woczach/wodox/outputs/outlines/stl/wodox_bottom_left.stl

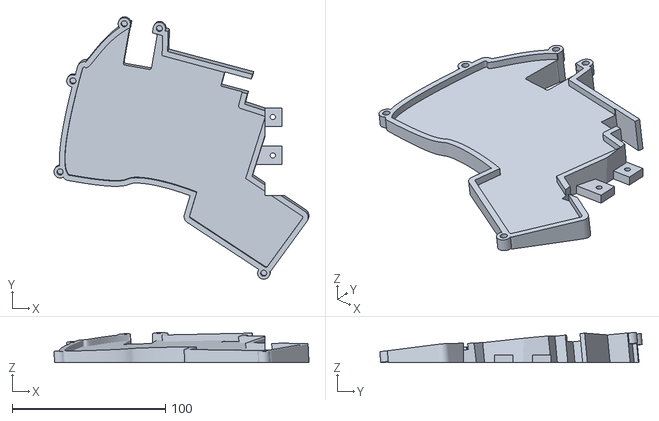
[picture p1: CAD file, 2026-10-24]
outputs/outlines/stl/wodox_bottom_left.stl
166.3 x 171.2 x 19.6
