woczach/wodox/outputs/outlines/wodox_board.stl

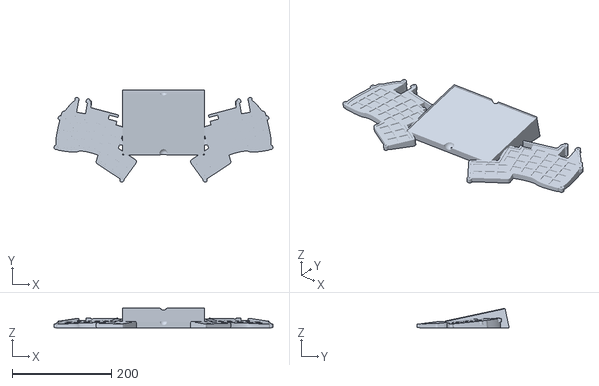
[picture p2: CAD file, 2026-10-24]
outputs/outlines/wodox_board.stl
441.4 x 186.3 x 39.3
