woczach/wodox/outputs/outlines/stl/wodox_top_right.stl

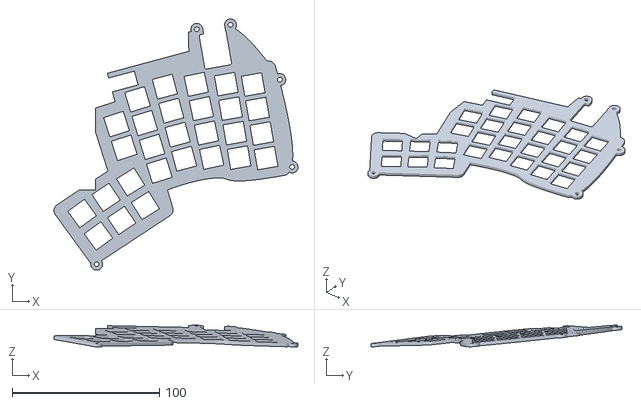
[picture p3: CAD file, 2026-10-24]
outputs/outlines/stl/wodox_top_right.stl
165.9 x 170.8 x 14.9
