woczach/wodox/outputs/outlines/wodox_board_edgetcuts_raw.dxf

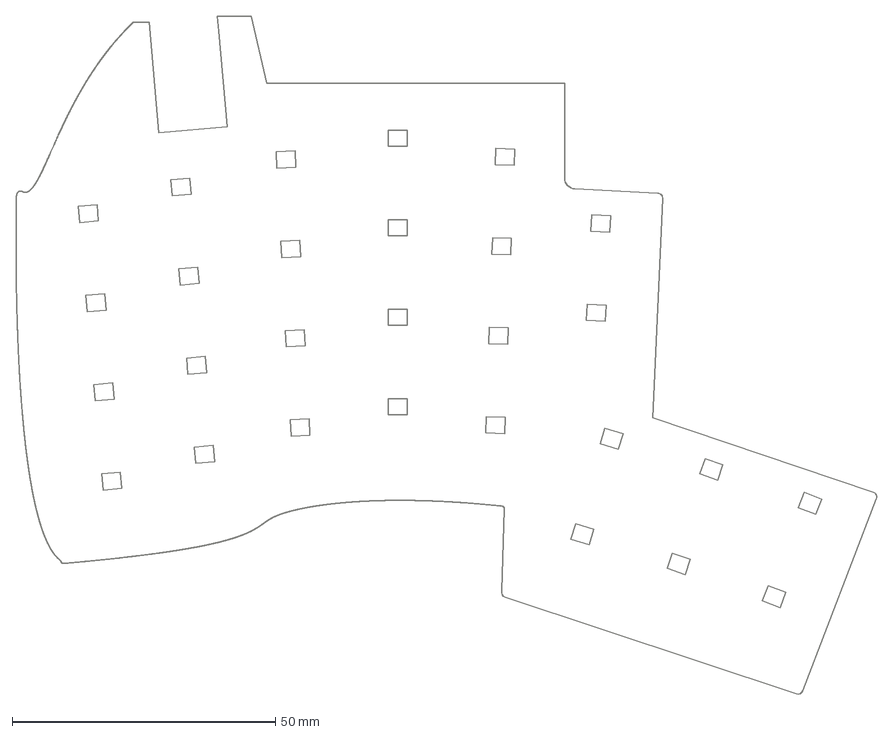
[picture p4: CAD file, 2026-10-01]
outputs/outlines/wodox_board_edgetcuts_raw.dxf
163.6 x 128.9 mm
