woczach/wodox/outputs/outlines/raw.dxf

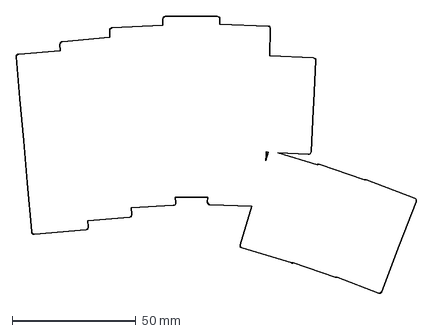
[picture p5: CAD file, 2026-09-26]
outputs/outlines/raw.dxf
161.9 x 112.0 mm
