woczach/wodox/outputs/outlines/board.dxf

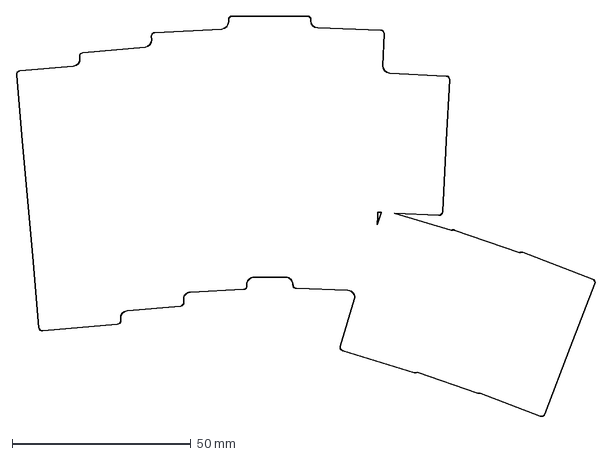
[picture p6: CAD file, 2026-09-26]
outputs/outlines/board.dxf
161.9 x 112.0 mm
