woczach/wodox/outputs/outlines/wodox_board.scad

// Wodox keyboard PCB outline - auto-generated from main_pcb.kicad_pcb (Edge.Cuts)
// Units: millimetres. Origin = board lower-left corner. Board: 163.551 x 128.759 mm.
// Use the embedded polygon below, or uncomment the DXF imports at the bottom.

BOARD_THICKNESS = 2.2;      // solid height (mm) - needs to exceed LIP_Z1
WANT_CUTOUTS    = true;     // 28 stepped Choc v1 switch cutouts
// Choc v1 stepped cutout profile (all squares, centred on each switch):
CHOC_OUTER      = 14.7;     // size below and above the lip
CHOC_LIP        = 14.0;     // retention lip size
LIP_Z0          = 0.95;      // lip bottom height
LIP_Z1          = 2.05;      // lip top height
$fn = 48;

// RP2040-Matrix module placement (from KiCad footprint Cmts.User layer)
RP2040_POS = [32.898, 116.202];     // module centre, SCAD coords
RP2040_ROT = 5;                     // KiCad footprint rotation (deg)

// PJ320E 3.5mm audio jack placement (from KiCad footprint F.SilkS layer)
PJ320E_POS = [91.95, 114.3325];     // jack footprint centre, SCAD coords
PJ320E_ROT = -90;                   // KiCad footprint rotation (deg)

// Jack plug clearance: 1 cm opening, and 1 cm past the PCB edge at the jack.
JACK_PLUG_D   = 10;                 // clearance across the plug (mm)
JACK_EXT      = 10;                 // clearance beyond the PCB edge (mm)
JACK_PCB_EDGE = 104.2393;           // x of the board edge next to the jack
JACK_INNER_Y  = 2.1;                // jack body inner face (local y)
JACK_OUTER_Y  = PJ320E_POS[0] - (JACK_PCB_EDGE + JACK_EXT);

// Split: the second half is a mirror of the first, placed to the right
GAP        = 0;                    // single layout gap, all elements (0 = touching)
HALF_ROT   = -15;                   // rotate each half inward (deg)
HALF_TILT  = 6;                     // tilt each half about the two bottom screws (deg)

// Bottom plate: same outline as the board, solid (no switch cutouts)
PLATE_THICKNESS = 3;                // plate thickness (mm)

// Touchpad base (from ~/git/other/tuchpad base.scad)
// The source is Y-up: the flat touchpad face points towards +Y, the slanted
// underside towards -Y and the thick/high edge towards +X. The slanted
// underside is the bottom, so it is levelled onto the print bed below; the
// flat face then becomes the inclined touchpad surface.
TOUCHPAD      = true;               // place the touchpad base between the halves
TP_LONG       = 123.3;              // inner/touchpad depth (outer = +2*TP_WALL)
TP_LONG2      = 163;                // inner/touchpad width (outer = +2*TP_WALL)
TP_WALL       = 1.5;                // material thickness
TP_H1         = 1.5;                // flat-face edge offset
TP_H2         = 2.5;                // edge step height
TP_HW1        = 13.2;               // low end thickness
TP_HW2        = 40.2;               // high end thickness
TP_HW3        = 13;                 // side/end thickness
TP_TALL_WALL  = "back";             // thick edge: "back" (+Y) or "front" (-Y)

TP_OUTER_W    = TP_LONG2 + 2*TP_WALL;  // 166.0 - width across the split
TP_OUTER_D    = TP_LONG  + 2*TP_WALL;  // 126.3 - depth front-to-back
TP_LEVEL      = atan2(TP_HW2 - TP_HW1, TP_OUTER_D);  // underside slope (deg)

// Clearance between the real PCB and the printed parts (per side, mm)
PCB_CLEARANCE   = 0.2;

// Outline (wall) around each plate
OUTLINE         = 3.5;                // outline width, outward (mm)
TOP_OUTLINE_H   = BOARD_THICKNESS;  // top plate outline height (mm) = 3
BOT_OUTLINE_H   = 7;                // bottom plate outline height (mm)

// Screw joints: M3 heat-set inserts in the bottom outline, M3 clearance in top
M3_INSERT_D     = 4.0;              // insert hole diameter (mm)
M3_INSERT_H     = 5.1;              // insert hole depth (mm)
M3_CLEAR_D      = 3.4;              // M3 screw clearance hole diameter (mm)
SCREW_BOSS_WALL = 2;                // wall around each screw / barrel (mm)
// Screw centres, on the ring mid-line (SCAD coords). One half; mirrored with it.
// Offsets set so each screw's barrel (OD M3_INSERT_D+2*SCREW_BOSS_WALL) has
// its inner edge on the board outline -> not inside the plates.
// The two bottom screws define the single tilt axis (see half_transform).
SCREW_BOTTOM_LEFT  = [  3.11,  25.22];
SCREW_BOTTOM_RIGHT = [148.48,  -4.20];
screws = [
  [ 41.50, 132.96],   // top
 // [167.75,  37.31],   // right / thumb
  SCREW_BOTTOM_RIGHT,  // bottom-right
  //[ 88.33,  31.04],   // bottom-middle
  SCREW_BOTTOM_LEFT,   // bottom-left
  //[120.26,  99.44],   // upper-right corner
  [ -4.20,  85.00],   // left-upper
  [ 18.61, 129.90],   // top-left
];

// Extra clearance around the component cutouts so the modules drop in cleanly.
COMPONENT_CLEARANCE = 0.3;          // per side (mm)

// The RP2040 USB exit must be fully open between the two top screws. Widen the
// USB cutout to the clear gap between their boss circles so no board is left
// between the screws (the bosses themselves stay intact).
USB_BOSS_R  = M3_INSERT_D/2 + SCREW_BOSS_WALL;
function _usb_local_x(p) =
    (p[0]-RP2040_POS[0])*cos(RP2040_ROT) + (p[1]-RP2040_POS[1])*sin(RP2040_ROT);
USB_GAP_MIN = _usb_local_x(screws[len(screws)-1]) + USB_BOSS_R;  // top-left screw
USB_GAP_MAX = _usb_local_x(screws[0]) - USB_BOSS_R;              // top screw
USB_GAP_W   = USB_GAP_MAX - USB_GAP_MIN;
USB_GAP_CX  = (USB_GAP_MIN + USB_GAP_MAX)/2;

outer = [[122.8791,94.0923],[122.8803,94.1250],[122.8804,94.1577],[122.8794,94.1904],[122.8774,94.2231],[122.8743,94.2557],[122.8701,94.2881],[122.8649,94.3204],[122.8586,94.3526],[122.8513,94.3844],[122.8429,94.4161],[122.8335,94.4474],[122.8231,94.4784],[122.8117,94.5091],[122.7993,94.5394],[122.7859,94.5692],[122.7715,94.5986],[122.7562,94.6275],[122.7399,94.6559],[122.7227,94.6838],[122.7046,94.7111],[122.6856,94.7377],[122.6658,94.7637],[122.6451,94.7891],[122.6236,94.8138],[122.6013,94.8377],[122.5783,94.8610],[122.5545,94.8834],[122.5299,94.9051],[122.5047,94.9259],[122.4788,94.9459],[122.4523,94.9651],[122.4251,94.9833],[122.3974,95.0007],[122.3691,95.0171],[122.3403,95.0327],[122.3110,95.0472],[122.2812,95.0608],[122.2510,95.0735],[122.2204,95.0851],[122.1895,95.0957],[122.1582,95.1053],[122.1266,95.1139],[122.0948,95.1214],[122.0627,95.1279],[122.0304,95.1333],[121.9980,95.1377],[121.9654,95.1410],[121.9328,95.1433],[106.1334,95.9713],[106.0688,95.9757],[106.0044,95.9822],[105.9403,95.9908],[105.8765,96.0015],[105.8130,96.0142],[105.7500,96.0290],[105.6875,96.0458],[105.6256,96.0646],[105.5643,96.0855],[105.5037,96.1082],[105.4439,96.1330],[105.3849,96.1596],[105.3269,96.1882],[105.2697,96.2186],[105.2136,96.2508],[105.1586,96.2849],[105.1047,96.3207],[105.0520,96.3582],[105.0005,96.3975],[104.9503,96.4383],[104.9014,96.4808],[104.8540,96.5248],[104.8080,96.5704],[104.7635,96.6174],[104.7206,96.6658],[104.6792,96.7156],[104.6395,96.7667],[104.6015,96.8190],[104.5651,96.8726],[104.5305,96.9273],[104.4977,96.9831],[104.4668,97.0399],[104.4376,97.0977],[104.4104,97.1564],[104.3851,97.2160],[104.3617,97.2763],[104.3403,97.3374],[104.3209,97.3991],[104.3034,97.4614],[104.2880,97.5243],[104.2747,97.5876],[104.2634,97.6514],[104.2542,97.7154],[104.2470,97.7797],[104.2419,97.8443],[104.2390,97.9089],[104.2381,97.9736],[104.2393,98.0383],[104.2393,116.0264],[47.6811,116.0264],[44.6811,128.7592],[38.2774,128.7592],[38.5301,125.8702],[40.1164,107.7395],[27.1658,106.6065],[25.3268,127.6262],[22.2811,127.6262],[21.3781,126.7369],[20.5062,125.8325],[19.6645,124.9147],[18.8523,123.9849],[18.0690,123.0449],[17.3137,122.0962],[16.5857,121.1404],[15.8843,120.1791],[15.2088,119.2138],[14.5583,118.2463],[13.9321,117.2781],[13.3295,116.3107],[12.7498,115.3458],[12.1922,114.3850],[11.6560,113.4298],[11.1404,112.4819],[10.6446,111.5429],[10.1680,110.6143],[9.7098,109.6977],[9.2692,108.7948],[8.8456,107.9071],[8.4381,107.0363],[8.0460,106.1838],[7.6686,105.3514],[7.3051,104.5406],[6.9548,103.7530],[6.6170,102.9902],[6.2909,102.2539],[5.9757,101.5455],[5.6707,100.8667],[5.3753,100.2190],[5.0885,99.6042],[4.8097,99.0237],[4.5382,98.4793],[4.2732,97.9723],[4.0139,97.5046],[3.7597,97.0776],[3.5097,96.6929],[3.2632,96.3522],[3.0195,96.0570],[2.7779,95.8090],[2.5375,95.6096],[2.2978,95.4607],[2.0578,95.3636],[1.8169,95.3200],[1.5743,95.3316],[1.3293,95.3999],[1.0811,95.5264],[1.0439,95.5378],[1.0072,95.5468],[0.9710,95.5537],[0.9354,95.5583],[0.9003,95.5609],[0.8659,95.5614],[0.8320,95.5599],[0.7987,95.5565],[0.7660,95.5513],[0.7339,95.5442],[0.7025,95.5354],[0.6717,95.5249],[0.6416,95.5127],[0.6121,95.4990],[0.5833,95.4838],[0.5552,95.4672],[0.5277,95.4491],[0.5010,95.4298],[0.4750,95.4091],[0.4497,95.3873],[0.4252,95.3643],[0.4014,95.3402],[0.3784,95.3150],[0.3561,95.2889],[0.3346,95.2619],[0.3139,95.2341],[0.2940,95.2054],[0.2750,95.1760],[0.2567,95.1460],[0.2393,95.1153],[0.2227,95.0841],[0.2070,95.0524],[0.1922,95.0202],[0.1782,94.9877],[0.1651,94.9548],[0.1530,94.9218],[0.1417,94.8885],[0.1314,94.8550],[0.1220,94.8215],[0.1135,94.7880],[0.1060,94.7545],[0.0995,94.7212],[0.0939,94.6880],[0.0893,94.6550],[0.0857,94.6223],[0.0832,94.5899],[0.0816,94.5579],[0.0811,94.5264],[0.0793,94.4468],[0.0742,94.2120],[0.0667,93.8284],[0.0573,93.3024],[0.0468,92.6402],[0.0360,91.8483],[0.0254,90.9330],[0.0158,89.9006],[0.0079,88.7574],[0.0024,87.5098],[0.0000,86.1641],[0.0014,84.7267],[0.0072,83.2038],[0.0183,81.6019],[0.0353,79.9273],[0.0588,78.1862],[0.0896,76.3851],[0.1284,74.5303],[0.1760,72.6281],[0.2329,70.6849],[0.2998,68.7069],[0.3776,66.7006],[0.4669,64.6722],[0.5683,62.6282],[0.6827,60.5748],[0.8106,58.5184],[0.9528,56.4653],[1.1100,54.4218],[1.2829,52.3944],[1.4722,50.3892],[1.6785,48.4128],[1.9027,46.4713],[2.1453,44.5712],[2.4071,42.7188],[2.6888,40.9204],[2.9911,39.1823],[3.3147,37.5110],[3.6603,35.9127],[4.0285,34.3937],[4.4201,32.9605],[4.8358,31.6193],[5.2763,30.3764],[5.7423,29.2383],[6.2345,28.2113],[6.7535,27.3016],[7.3001,26.5157],[7.8750,25.8599],[8.4789,25.3404],[8.4821,25.3205],[8.4860,25.3006],[8.4905,25.2810],[8.4956,25.2614],[8.5014,25.2421],[8.5079,25.2229],[8.5150,25.2040],[8.5226,25.1853],[8.5310,25.1669],[8.5399,25.1488],[8.5494,25.1310],[8.5595,25.1135],[8.5702,25.0963],[8.5814,25.0796],[8.5932,25.0632],[8.6055,25.0472],[8.6184,25.0316],[8.6318,25.0164],[8.6456,25.0017],[8.6600,24.9875],[8.6748,24.9738],[8.6900,24.9605],[8.7057,24.9478],[8.7218,24.9356],[8.7383,24.9240],[8.7552,24.9128],[8.7724,24.9023],[8.7900,24.8923],[8.8079,24.8830],[8.8261,24.8742],[8.8446,24.8660],[8.8633,24.8585],[8.8823,24.8516],[8.9015,24.8453],[8.9209,24.8397],[8.9404,24.8347],[8.9602,24.8303],[8.9800,24.8266],[9.0000,24.8236],[9.0201,24.8212],[9.0402,24.8195],[9.0604,24.8185],[9.0806,24.8182],[9.1008,24.8185],[9.1209,24.8195],[9.1411,24.8211],[9.1611,24.8235],[9.1811,24.8264],[11.4319,25.0267],[13.5858,25.2274],[15.6452,25.4284],[17.6125,25.6297],[19.4900,25.8313],[21.2801,26.0329],[22.9852,26.2346],[24.6075,26.4362],[26.1495,26.6376],[27.6135,26.8389],[29.0019,27.0399],[30.3170,27.2405],[31.5613,27.4407],[32.7370,27.6403],[33.8465,27.8393],[34.8922,28.0376],[35.8765,28.2351],[36.8016,28.4317],[37.6700,28.6274],[38.4841,28.8221],[39.2461,29.0157],[39.9584,29.2081],[40.6235,29.3992],[41.2436,29.5889],[41.8211,29.7773],[42.3585,29.9641],[42.8579,30.1493],[43.3219,30.3329],[43.7527,30.5147],[44.1528,30.6946],[44.5244,30.8726],[44.8700,31.0487],[45.1919,31.2226],[45.4924,31.3944],[45.7740,31.5639],[46.0389,31.7311],[46.2896,31.8959],[46.5284,32.0582],[46.7576,32.2180],[46.9797,32.3751],[47.1970,32.5294],[47.4118,32.6809],[47.6265,32.8296],[47.8434,32.9752],[48.0650,33.1178],[48.2936,33.2573],[48.5315,33.3935],[48.7811,33.5264],[49.0508,33.6584],[49.3473,33.7916],[49.6706,33.9258],[50.0207,34.0605],[50.3978,34.1955],[50.8016,34.3305],[51.2324,34.4652],[51.6900,34.5991],[52.1744,34.7320],[52.6858,34.8637],[53.2240,34.9936],[53.7891,35.1217],[54.3812,35.2474],[55.0001,35.3705],[55.6459,35.4907],[56.3187,35.6077],[57.0184,35.7211],[57.7450,35.8306],[58.4985,35.9359],[59.2790,36.0367],[60.0864,36.1327],[60.9208,36.2234],[61.7822,36.3087],[62.6705,36.3882],[63.5858,36.4615],[64.5280,36.5284],[65.4973,36.5886],[66.4935,36.6416],[67.5168,36.6873],[68.5670,36.7252],[69.6443,36.7550],[70.7486,36.7765],[71.8798,36.7893],[73.0382,36.7931],[74.2235,36.7875],[75.4359,36.7723],[76.6754,36.7472],[77.9419,36.7117],[79.2354,36.6656],[80.5561,36.6086],[81.9038,36.5403],[83.2786,36.4605],[84.6804,36.3687],[86.1094,36.2648],[87.5654,36.1483],[89.0486,36.0190],[90.5589,35.8764],[92.0962,35.7204],[92.1175,35.7231],[92.1388,35.7250],[92.1602,35.7261],[92.1816,35.7264],[92.2030,35.7260],[92.2244,35.7249],[92.2457,35.7230],[92.2669,35.7203],[92.2881,35.7168],[92.3091,35.7126],[92.3299,35.7077],[92.3505,35.7020],[92.3710,35.6956],[92.3911,35.6885],[92.4111,35.6806],[92.4307,35.6721],[92.4500,35.6628],[92.4689,35.6529],[92.4875,35.6423],[92.5058,35.6310],[92.5235,35.6191],[92.5409,35.6066],[92.5578,35.5935],[92.5742,35.5797],[92.5901,35.5654],[92.6055,35.5505],[92.6204,35.5351],[92.6347,35.5192],[92.6484,35.5028],[92.6615,35.4858],[92.6741,35.4685],[92.6859,35.4507],[92.6972,35.4325],[92.7078,35.4139],[92.7177,35.3949],[92.7269,35.3756],[92.7355,35.3559],[92.7433,35.3360],[92.7504,35.3158],[92.7568,35.2954],[92.7625,35.2747],[92.7674,35.2539],[92.7716,35.2329],[92.7750,35.2118],[92.7777,35.1905],[92.7796,35.1692],[92.7807,35.1478],[92.7811,35.1264],[92.2996,19.6387],[92.2905,19.6073],[92.2825,19.5755],[92.2755,19.5436],[92.2696,19.5114],[92.2647,19.4790],[92.2609,19.4465],[92.2582,19.4139],[92.2565,19.3812],[92.2559,19.3485],[92.2564,19.3158],[92.2579,19.2831],[92.2605,19.2505],[92.2642,19.2180],[92.2689,19.1856],[92.2747,19.1534],[92.2815,19.1214],[92.2894,19.0896],[92.2983,19.0582],[92.3083,19.0270],[92.3192,18.9961],[92.3312,18.9657],[92.3441,18.9356],[92.3581,18.9060],[92.3729,18.8769],[92.3888,18.8482],[92.4055,18.8201],[92.4232,18.7926],[92.4418,18.7656],[92.4612,18.7393],[92.4815,18.7136],[92.5026,18.6886],[92.5245,18.6644],[92.5472,18.6408],[92.5707,18.6180],[92.5949,18.5960],[92.6198,18.5747],[92.6454,18.5543],[92.6716,18.5348],[92.6985,18.5161],[92.7260,18.4983],[92.7540,18.4814],[92.7826,18.4655],[92.8116,18.4504],[92.8412,18.4364],[92.8712,18.4233],[92.9016,18.4112],[92.9324,18.4001],[92.9635,18.3900],[148.2160,0.0664],[148.2467,0.0552],[148.2778,0.0449],[148.3092,0.0358],[148.3409,0.0276],[148.3729,0.0205],[148.4050,0.0144],[148.4373,0.0094],[148.4698,0.0055],[148.5024,0.0026],[148.5351,0.0007],[148.5678,0.0000],[148.6005,0.0003],[148.6332,0.0017],[148.6659,0.0042],[148.6984,0.0077],[148.7308,0.0123],[148.7630,0.0179],[148.7951,0.0246],[148.8268,0.0324],[148.8584,0.0412],[148.8896,0.0510],[148.9205,0.0618],[148.9510,0.0736],[148.9811,0.0864],[149.0108,0.1002],[149.0400,0.1150],[149.0687,0.1307],[149.0969,0.1473],[149.1245,0.1649],[149.1515,0.1833],[149.1779,0.2027],[149.2037,0.2228],[149.2288,0.2438],[149.2532,0.2657],[149.2768,0.2883],[149.2997,0.3116],[149.3219,0.3357],[149.3432,0.3605],[149.3637,0.3860],[149.3834,0.4122],[149.4022,0.4390],[149.4201,0.4664],[149.4371,0.4943],[149.4532,0.5228],[149.4683,0.5518],[149.4825,0.5813],[149.4957,0.6112],[149.5079,0.6416],[163.4843,37.0512],[163.4955,37.0820],[163.5057,37.1131],[163.5149,37.1445],[163.5231,37.1762],[163.5302,37.2081],[163.5363,37.2403],[163.5413,37.2726],[163.5452,37.3051],[163.5481,37.3377],[163.5500,37.3703],[163.5507,37.4031],[163.5504,37.4358],[163.5490,37.4685],[163.5465,37.5011],[163.5430,37.5336],[163.5384,37.5660],[163.5328,37.5983],[163.5261,37.6303],[163.5183,37.6621],[163.5096,37.6936],[163.4997,37.7248],[163.4889,37.7557],[163.4771,37.7862],[163.4643,37.8163],[163.4505,37.8460],[163.4357,37.8752],[163.4200,37.9039],[163.4034,37.9321],[163.3858,37.9597],[163.3674,37.9868],[163.3480,38.0132],[163.3279,38.0389],[163.3069,38.0640],[163.2850,38.0884],[163.2624,38.1121],[163.2391,38.1350],[163.2150,38.1571],[163.1902,38.1785],[163.1647,38.1990],[163.1385,38.2186],[163.1117,38.2374],[163.0843,38.2553],[163.0564,38.2723],[163.0279,38.2884],[162.9989,38.3036],[162.9694,38.3177],[162.9394,38.3310],[162.9091,38.3432],[120.9427,52.5264]];

// Choc v1 (CPG1350) switch centres from main_pcb.kicad_pcb (switch_choc_v1_v2).
// [x, y, rotation_deg] in SCAD coords; rotation matches the ergo switch angle.
switches = [
  [142.3743, 14.0722, 159.0],
  [124.4095, 20.2580, 161.0],
  [106.2397, 25.8130, 163.0],
  [149.1833, 31.8102, 159.0],
  [18.6183, 35.7507, -175.0],
  [130.5953, 38.2228, 161.0],
  [36.2448, 40.8062, -175.0],
  [111.7948, 43.9828, 163.0],
  [54.2299, 45.8931, -177.0],
  [90.9474, 46.3593, 178.0],
  [72.5874, 49.8593, 180.0],
  [17.1367, 52.6860, -175.0],
  [34.7631, 57.7415, -175.0],
  [53.3401, 62.8698, -177.0],
  [91.5407, 63.3489, 178.0],
  [72.5874, 66.8593, 180.0],
  [110.0007, 67.7047, 177.0],
  [15.6550, 69.6213, -175.0],
  [33.2815, 74.6768, -175.0],
  [52.4504, 79.8465, -177.0],
  [92.1340, 80.3385, 178.0],
  [72.5874, 83.8593, 180.0],
  [110.8904, 84.6814, 177.0],
  [14.1734, 86.5566, -175.0],
  [31.7998, 91.6121, -175.0],
  [51.5607, 96.8232, -177.0],
  [92.7273, 97.3282, 178.0],
  [72.5874, 100.8593, 180.0],
];

module board_2d() {
    // grown outward by PCB_CLEARANCE so the real board drops into the print
    offset(delta = PCB_CLEARANCE) polygon(points=outer);
}

// Stepped switch holes: 14.7 from z0..LIP_Z0, 14.0 from LIP_Z0..LIP_Z1,
// then 14.7 again from LIP_Z1 up through the top.
// Each square is centered (center=true) on the switch centre s=[x,y,rot] from
// the PCB (footprint origin = the Choc centre peg at local (0,0)), then rotated
// to the switch's ergo angle.
module switch_cutouts_3d(t=BOARD_THICKNESS) {
    for (s=switches)
        translate([s[0], s[1], 0]) rotate([0, 0, s[2]]) {
            linear_extrude(height=LIP_Z0)
                square([CHOC_OUTER, CHOC_OUTER], center=true);
            translate([0, 0, LIP_Z0])
                linear_extrude(height=LIP_Z1-LIP_Z0)
                    square([CHOC_LIP, CHOC_LIP], center=true);
            translate([0, 0, LIP_Z1])
                linear_extrude(height=t-LIP_Z1)
                    square([CHOC_OUTER, CHOC_OUTER], center=true);
        }
}

module board_3d(with_cutouts=WANT_CUTOUTS, t=BOARD_THICKNESS) {
    difference() {
        linear_extrude(height=t) board_2d();
        if (with_cutouts) switch_cutouts_3d(t=t);
    }
}

// --- Component 2D profiles (used as through-cutouts) ---
module rp2040_body_2d() {       // rounded rect 18 x 23.5, r=1 + clearance
    translate([RP2040_POS[0], RP2040_POS[1]])
      rotate([0,0,RP2040_ROT]) mirror([0,1,0])
        offset(r=1 + COMPONENT_CLEARANCE) square([16, 21.5], center=true);
}

module rp2040_usb_2d() {        // USB exit: full clear gap between top screws
    translate([RP2040_POS[0], RP2040_POS[1]])
      rotate([0,0,RP2040_ROT]) mirror([0,1,0])
        translate([USB_GAP_CX, -10.91]) square([USB_GAP_W, 30.08], center=true);
}

module pj320e_2d() {            // 3.5mm jack slot: 1 cm plug, 1 cm past PCB
    // starts at the jack body (local y=2.1) and extends JACK_EXT past the
    // board edge so the plug has 1 cm of clear space outside the PCB.
    translate([PJ320E_POS[0], PJ320E_POS[1]])
      rotate([0,0,PJ320E_ROT]) mirror([0,1,0])
        translate([2.75, (JACK_INNER_Y + JACK_OUTER_Y)/2])
          square([JACK_PLUG_D, JACK_INNER_Y - JACK_OUTER_Y], center=true);
}

// RP2040 + USB + jack punched through the full stack (bottom plate -> top plate).
// `below` extends the cut downwards, e.g. through the solid tilted base.
module component_cutouts(below = 0) {
    translate([0, 0, -GAP - PLATE_THICKNESS - below])
      linear_extrude(height = BOARD_THICKNESS + GAP + PLATE_THICKNESS + 2 + below) {
          rp2040_body_2d();
          rp2040_usb_2d();
          pj320e_2d();
      }
}

// bottom plate: board outline only, solid (no switch cutouts),
// sitting GAP below the top plate
module bottom_plate(t=PLATE_THICKNESS, gap=GAP) {
    translate([0, 0, -gap - t]) linear_extrude(height=t) board_2d();
}

// outline wall: OUTLINE-wide ring around the board shape, h tall, based at z0
module plate_outline(h, z0) {
    difference() {
        translate([0, 0, z0])
            linear_extrude(height=h) offset(delta=OUTLINE) board_2d();
        translate([0, 0, z0 - 1])
            linear_extrude(height=h + 2) board_2d();
    }
}

// M3 screw clearance holes through the top outline
module top_screw_holes() {
    for (s=screws)
        translate([s[0], s[1], -1])
            cylinder(d=M3_CLEAR_D, h=BOARD_THICKNESS+2, $fn=48);
}

// M3 heat-set insert holes in the bottom outline (blind, from its top face)
module bottom_insert_holes() {
    ztop = -GAP - PLATE_THICKNESS + BOT_OUTLINE_H;   // top of bottom outline
    for (s=screws)
        translate([s[0], s[1], ztop - M3_INSERT_H])
            cylinder(d=M3_INSERT_D, h=M3_INSERT_H+1, $fn=48);
}

// Local barrels around each screw so the thin outline has enough material
// for the insert (bottom) and clearance (top) holes.
module screw_bosses_top() {
    d = M3_INSERT_D + 2*SCREW_BOSS_WALL;
    for (s=screws)
        translate([s[0], s[1], 0])
            cylinder(d=d, h=TOP_OUTLINE_H, $fn=48);
}
module screw_bosses_bottom() {
    d = M3_INSERT_D + 2*SCREW_BOSS_WALL;
    for (s=screws)
        translate([s[0], s[1], -GAP - PLATE_THICKNESS])
            cylinder(d=d, h=BOT_OUTLINE_H, $fn=48);
}

// TOP printable part: switch plate + top outline + screw clearance holes
module top_part() {
    difference() {
        union() {
            board_3d();
            plate_outline(TOP_OUTLINE_H, 0);
            screw_bosses_top();
        }
        component_cutouts();
        top_screw_holes();
    }
}

// BOTTOM printable part: bottom plate + bottom outline + insert holes
module bottom_part() {
    difference() {
        union() {
            bottom_plate();
            plate_outline(BOT_OUTLINE_H, -GAP - PLATE_THICKNESS);
            screw_bosses_bottom();
        }
        component_cutouts();
        bottom_insert_holes();
    }
}

// --- Touchpad base ----------------------------------------------------------
// Cross-sections in the XY plane, extruded along Z (source orientation).
TP_PROFILE1 = [
    [0,                   0],
    [0,          -TP_H1],
    [TP_LONG,    -TP_H1],
    [TP_LONG,    -TP_H1 + TP_H2],
    [TP_LONG + TP_WALL, -TP_H1 + TP_H2],
    [TP_LONG + TP_WALL, -TP_H1 + TP_H2 - TP_HW2],
    [-TP_WALL,   -TP_H1 + TP_H2 - TP_HW1],
    [-TP_WALL,    0]
];

TP_PROFILE2 = [
    [0,                   0],
    [0,          -TP_H1],
    [TP_LONG2,   -TP_H1],
    [TP_LONG2,   -TP_H1 + TP_H2],
    [TP_LONG2 + TP_WALL, -TP_H1 + TP_H2],
    [TP_LONG2 + TP_WALL, -TP_H1 + TP_H2 - TP_HW3],
    [-TP_WALL,   -TP_H1 + TP_H2 - TP_HW3],
    [-TP_WALL,    0]
];

module tp_profile() {
    polygon(points = TP_PROFILE1);
}

module tp_profile2() {
    polygon(points = TP_PROFILE2);
}

module touchpad_base_raw() {
    // side-wall profile extruded to the outer width, so it fills the corners
    translate([0, 0, -TP_WALL])
        linear_extrude(height = TP_LONG2 + 2*TP_WALL)
            tp_profile();
    // end-wall profile only spans the inner depth and fits between the sides
    translate([0, 0, TP_LONG2])
        rotate([90, 90, 90])
            linear_extrude(height = TP_LONG)
                tp_profile2();
}

// Level the slanted underside onto the bed, then put the thick edge at +Y.
module touchpad_base_back() {
    rotate([90, 0, 90])
        rotate([0, 0, TP_LEVEL])
            touchpad_base_raw();
}

module touchpad_base() {
    if (TP_TALL_WALL == "front")
        mirror([0, 1, 0]) touchpad_base_back();
    else
        touchpad_base_back();
}

// one complete half (both printable parts)
module board_half() {
    union() {
        top_part();
        bottom_part();
    }
}

function _max_x(p, i=0, m=-1e9) =
    i >= len(p) ? m : _max_x(p, i+1, max(m, p[i][0]));

function _max_y(p, i=0, m=-1e9) =
    i >= len(p) ? m : _max_y(p, i+1, max(m, p[i][1]));

BOARD_W = _max_x(outer);        // width of one half (board starts at x=0)
BOARD_H = _max_y(outer);        // depth of one half (board starts at y=0)
ZBED    = -GAP - PLATE_THICKNESS;

BOT_BOSS_R = M3_INSERT_D/2 + SCREW_BOSS_WALL;

// Single tilt axis: the line through the two bottom screws, at the underside
// of the bottom plate. Positive HALF_TILT lifts the back of the half.
TILT_A   = [SCREW_BOTTOM_LEFT[0],  SCREW_BOTTOM_LEFT[1],  ZBED];
TILT_B   = [SCREW_BOTTOM_RIGHT[0], SCREW_BOTTOM_RIGHT[1], ZBED];
TILT_PHI = atan2(TILT_B[1] - TILT_A[1], TILT_B[0] - TILT_A[0]);

function _rot_z(p, a) = [
    p[0]*cos(a) - p[1]*sin(a),
    p[0]*sin(a) + p[1]*cos(a),
    p[2]
];
function _rot_x(p, a) = [
    p[0],
    p[1]*cos(a) - p[2]*sin(a),
    p[1]*sin(a) + p[2]*cos(a)
];
// Height of a point on the bottom plane after tilting about the screw axis.
function tilt_z(x, y, a) =
    let(p0 = [x - TILT_A[0], y - TILT_A[1], 0],
        p1 = _rot_z(p0, -TILT_PHI),
        p2 = _rot_x(p1, a),
        p3 = _rot_z(p2, TILT_PHI))
    ZBED + p3[2];

// XY of a point on the left half after the yaw + tilt used by half_transform.
function _half_xy(p, z = 0) =
    let(p0 = [p[0] - TILT_A[0], p[1] - TILT_A[1], z - TILT_A[2]],
        p1 = _rot_z(p0, -TILT_PHI),
        p2 = _rot_x(p1, HALF_TILT),
        p3 = _rot_z(p2, TILT_PHI),
        xt = p3[0] + TILT_A[0],
        yt = p3[1] + TILT_A[1],
        dx = xt - BOARD_W/2,
        dy = yt - BOARD_H/2)
    [BOARD_W/2 + dx*cos(HALF_ROT) - dy*sin(HALF_ROT),
     BOARD_H/2 + dx*sin(HALF_ROT) + dy*cos(HALF_ROT)];

// Lift the tilted half so its lowest point (outline or screw boss) sits on the
// bed; the wedge below then fills the gap.
TILT_SLOPE = abs(sin(HALF_TILT));
TILT_EDGE  = OUTLINE + PCB_CLEARANCE;
TILT_MIN_Z = min(
    min([for (p = outer) tilt_z(p[0], p[1], HALF_TILT)]) - TILT_EDGE*TILT_SLOPE,
    min([for (s = screws) tilt_z(s[0], s[1], HALF_TILT) - BOT_BOSS_R*TILT_SLOPE])
);
TILT_LIFT = max(0, ZBED - TILT_MIN_Z);

// Touchpad base placement: raised above the bottom plane and moved up in Y
// until it clears the thumb keycaps, so the halves squeeze to the smallest X.
// GAP=0 puts all parts together; GAP>0 separates them for printing.
// Profile2 is extruded along raw X over the inner depth only.
TP_LEVEL_PTS = concat(
    TP_PROFILE1,
    [for (p = TP_PROFILE2) [0, p[1]]],
    [for (p = TP_PROFILE2) [TP_LONG, p[1]]]
);
function _tp_lx(p) = p[0]*cos(TP_LEVEL) - p[1]*sin(TP_LEVEL);
function _tp_ly(p) = p[0]*sin(TP_LEVEL) + p[1]*cos(TP_LEVEL);
TP_YMIN      = min([for (p = TP_LEVEL_PTS) _tp_lx(p)]);
TP_YMAX      = max([for (p = TP_LEVEL_PTS) _tp_lx(p)]);
TP_Z0        = min([for (p = TP_LEVEL_PTS) _tp_ly(p)]);
TP_CX        = TP_LONG2/2;
TP_CY        = (TP_YMIN + TP_YMAX)/2;
TP_CY_ACT    = TP_TALL_WALL == "front" ? -TP_CY : TP_CY;

// Keep the touchpad bottom aligned with the keyboard bottom, and drop it 20 mm
// in Y so it nearly touches the keyboard at the front.
TP_LIFT   = 0;
TP_Y_DROP = 20;

// Choc v1 keycap envelope (18 x 17 keycaps).
KEYCAP_R   = sqrt(9*9 + 8.5*8.5);
TP_FRONT_Y = max([
    for (s = switches)
        if (s[0] > 100 && s[1] < 50) _half_xy(s)[1]
]) + KEYCAP_R + 2 - TP_Y_DROP;

// Inner-most point of the left half above the thumb clusters. The touchpad
// side is tightened to the printed outline there, minimising X.
function _tp_inner_best(i = 0, bx = -1e9, by = 0) =
    i >= len(outer) ? [bx, by] :
    let(q = _half_xy(outer[i]))
        (q[1] >= TP_FRONT_Y && q[0] > bx)
            ? _tp_inner_best(i + 1, q[0], q[1])
            : _tp_inner_best(i + 1, bx, by);
TP_INNER    = _tp_inner_best();
TP_LEFT_X0  = TP_INNER[0] + PCB_CLEARANCE;   // over the outline, never the PCB
TP_BOSS_Y   = TP_INNER[1];
TP_LEFT_X   = TP_LEFT_X0 + GAP;
TP_RIGHT_X0 = TP_LEFT_X0 + TP_OUTER_W;
TP_RIGHT_X  = TP_LEFT_X + TP_OUTER_W;
TP_CENTER_X = TP_LEFT_X + TP_OUTER_W/2;
TP_Y_POS    = TP_TALL_WALL == "front" ? TP_FRONT_Y + TP_YMAX : TP_FRONT_Y - TP_YMIN;
RIGHT_OFFSET0 = TOUCHPAD ? 2*TP_LEFT_X0 + TP_OUTER_W : 2*BOARD_W;
RIGHT_OFFSET  = TOUCHPAD ? RIGHT_OFFSET0 + 2*GAP : 2*BOARD_W + GAP;

// Joinery: the keyboard halves have bottom lips that slide into pockets cut
// into the touchpad base from below. The screws go up from under the lips into
// blind heat-set inserts in the touchpad base, so all bottoms stay flush.
TP_HALF_PTS = concat(
    [for (p = outer) _half_xy(p)],
    [_half_xy(outer[0])]
);
function _edge_x(p1, p2, y) =
    ((p1[1] <= y && y < p2[1]) || (p2[1] <= y && y < p1[1]))
        ? p1[0] + (y - p1[1])/(p2[1] - p1[1])*(p2[0] - p1[0])
        : -1e9;
function _maxx_at(pts, y, i = 0, m = -1e9) =
    i >= len(pts) - 1 ? m
    : _maxx_at(pts, y, i + 1, max(m, _edge_x(pts[i], pts[i+1], y)));

TP_MOUNT_Y    = [57, TP_BOSS_Y];
TP_INSET      = 5;
TP_LIP_W      = 12;
TP_LIP_T      = 5;
TP_LIP_MARGIN = 6;
TP_LIP_EMBED  = 2;   // lower lip part embedded in the bottom plate
TP_POCKET_C   = 0.3;
TP_SCREW_X_L  = TP_LEFT_X0 + TP_INSET;   // lip screw at GAP=0
TP_SCREW_X_R  = TP_RIGHT_X0 - TP_INSET;
TP_INS_X_L    = TP_LEFT_X + TP_INSET;    // insert (moves with GAP)
TP_INS_X_R    = TP_RIGHT_X - TP_INSET;
TP_LIP_L      = TP_INSET + TP_LIP_MARGIN;        // lip inside the touchpad
TP_POCKET_Z   = ZBED + TP_LIP_T + TP_POCKET_C;   // pocket ceiling / insert start

module touchpad_mount_cutouts() {
    // pockets for the keyboard lips, open to the side and bottom
    for (y = TP_MOUNT_Y) {
        translate([TP_LEFT_X - 0.5,
                   y - (TP_LIP_W + 2*TP_POCKET_C)/2, ZBED - 0.1])
            cube([TP_LIP_L + TP_POCKET_C + 0.5,
                  TP_LIP_W + 2*TP_POCKET_C,
                  TP_LIP_T + TP_POCKET_C + 0.1]);
        translate([TP_RIGHT_X - TP_LIP_L - TP_POCKET_C,
                   y - (TP_LIP_W + 2*TP_POCKET_C)/2, ZBED - 0.1])
            cube([TP_LIP_L + TP_POCKET_C + 0.5,
                  TP_LIP_W + 2*TP_POCKET_C,
                  TP_LIP_T + TP_POCKET_C + 0.1]);
    }
    // blind inserts above each lip pocket
    for (y = TP_MOUNT_Y) {
        translate([TP_INS_X_L, y, TP_POCKET_Z])
            cylinder(d = M3_INSERT_D, h = M3_INSERT_H + 0.1, $fn = 48);
        translate([TP_INS_X_R, y, TP_POCKET_Z])
            cylinder(d = M3_INSERT_D, h = M3_INSERT_H + 0.1, $fn = 48);
    }
}

module tp_lips_world() {
    eps = 0.01;   // avoid coplanar/touching surfaces in the union
    difference() {
        union() {
            for (y = TP_MOUNT_Y) {
                xstart = _maxx_at(TP_HALF_PTS, y);   // board edge
                // lower part embedded in the bottom plate for a strong joint
                translate([xstart - TP_LIP_EMBED - eps,
                           y - TP_LIP_W/2, ZBED + eps])
                    cube([TP_SCREW_X_L + TP_LIP_MARGIN
                          - (xstart - TP_LIP_EMBED - eps),
                          TP_LIP_W, PLATE_THICKNESS + 0.1]);
                // upper part above the bottom plate, clear of the PCB
                translate([xstart + eps, y - TP_LIP_W/2,
                           ZBED + PLATE_THICKNESS - 0.1])
                    cube([TP_SCREW_X_L + TP_LIP_MARGIN - xstart - eps,
                          TP_LIP_W, TP_LIP_T - PLATE_THICKNESS + 0.1]);
            }
        }
        for (y = TP_MOUNT_Y) {
            translate([TP_SCREW_X_L, y, ZBED - 1])
                cylinder(d = M3_CLEAR_D, h = TP_LIP_T + 2, $fn = 32);
            translate([TP_SCREW_X_L, y, ZBED - 0.1])
                cylinder(d = M3_CLEAR_D + 2.5, h = 1.6, $fn = 32);
        }
    }
}

// Finger scoops for lifting the touchpad out: one near the front edge and one
// near the back edge, centred across the width.
TP_FINGER_R     = 8;
TP_FINGER_EDGE  = 4;
TP_FINGER_X     = TP_CENTER_X;
TP_FINGER_Y0    = TP_FRONT_Y + TP_FINGER_EDGE;
TP_FINGER_Y1    = TP_Y_POS + TP_YMAX - TP_FINGER_EDGE;
TP_FINGER_Z0    = ZBED + TP_LIFT - TP_Z0
                  + (TP_FINGER_Y0 - TP_Y_POS)*tan(TP_LEVEL);
TP_FINGER_Z1    = ZBED + TP_LIFT - TP_Z0
                  + (TP_FINGER_Y1 - TP_Y_POS)*tan(TP_LEVEL);

module touchpad_finger_cutouts() {
    translate([TP_FINGER_X, TP_FINGER_Y0, TP_FINGER_Z0])
        sphere(r = TP_FINGER_R, $fn = 64);
    translate([TP_FINGER_X, TP_FINGER_Y1, TP_FINGER_Z1])
        sphere(r = TP_FINGER_R, $fn = 64);
}

module touchpad_placed() {
    difference() {
        translate([TP_CENTER_X - TP_CX, TP_Y_POS, ZBED + TP_LIFT - TP_Z0])
            touchpad_base();
        touchpad_mount_cutouts();
        touchpad_finger_cutouts();
        // Never cross the PCB "outer" polygons. Shifted with the touchpad so
        // the part keeps the same shape at any print GAP.
        translate([GAP, 0, 0])
            pcb_footprint_world();
        translate([GAP, 0, 0])
            translate([RIGHT_OFFSET0, 0, 0]) mirror([1,0,0])
                pcb_footprint_world();
    }
}

// Plan footprint of one touchpad at GAP=0. The keyboard outline is cut away
// where the touchpad overlaps it, but the PCB "outer" polygon is never crossed.
module touchpad_footprint_world() {
    translate([0, 0, -1000])
        linear_extrude(height = 2000)
            translate([TP_LEFT_X0, TP_FRONT_Y])
                square([TP_RIGHT_X0 - TP_LEFT_X0,
                        (TP_Y_POS + TP_YMAX) - TP_FRONT_Y]);
}

// Left PCB footprint at GAP=0, used to notch the touchpad so it never crosses
// the board outline (only the printed outline may overlap).
module pcb_footprint_world() {
    translate([0, 0, -1000])
        linear_extrude(height = 2000)
            offset(delta = PCB_CLEARANCE)
                polygon([for (p = outer) _half_xy(p)]);
}

// --- Tilted bottom wedge ----------------------------------------------------
// Solid wedge under the bottom part: flat on the bed, tilted on top to match
// the rotated bottom part.
module bottom_footprint_2d() {
    offset(delta = OUTLINE) board_2d();
}

module tilt_axis_rotate(a) {
    translate(TILT_A)
        rotate([0, 0, TILT_PHI])
            rotate([a, 0, 0])
                rotate([0, 0, -TILT_PHI])
                    translate(-TILT_A)
                        children();
}

module half_inverse(yaw) {
    tilt_axis_rotate(-HALF_TILT)
        translate([0, 0, -TILT_LIFT])
            translate([BOARD_W/2, BOARD_H/2, 0])
                rotate([0, 0, -yaw])
                    translate([-BOARD_W/2, -BOARD_H/2, 0])
                        children();
}

module bottom_wedge_local(yaw) {
    H = 80;   // enough to cover the tilted bottom height
    intersection() {
        translate([0, 0, ZBED - H])
            linear_extrude(height = H)
                bottom_footprint_2d();
        half_inverse(yaw)
            translate([-20, -20, ZBED])
                cube([220, 180, H]);
    }
}

module bottom_part_with_wedge(yaw) {
    CUT_BELOW = 100;
    difference() {
        union() {
            bottom_part();
            bottom_wedge_local(yaw);
        }
        component_cutouts(below = CUT_BELOW);
    }
}

// ---- Export selector -------------------------------------------------------
// Render a single printable part: openscad -D 'PART="top"' -D 'SIDE="left"' ...
PART = "all";    // "all" | "top" | "bottom" | "touchpad"
SIDE = "both";   // "both" | "left" | "right"

// Yaw about the half centre, then one tilt about the line through the two
// bottom screws. The half is lifted so nothing dips below the bed.
module half_transform(yaw) {
    translate([0, 0, TILT_LIFT])
        translate([BOARD_W/2, BOARD_H/2, 0])
            rotate([0, 0, yaw])
                translate([-BOARD_W/2, -BOARD_H/2, 0])
                    tilt_axis_rotate(HALF_TILT)
                        children();
}

module selected_parts() {
    if (PART == "top"    || PART == "all") top_part();
    if (PART == "bottom" || PART == "all") bottom_part_with_wedge(HALF_ROT);
}

module half_placed() {
    union() {
        // Cut the outline/bosses away where the touchpad overlaps them.
        difference() {
            half_transform(HALF_ROT) selected_parts();
            if (TOUCHPAD) touchpad_footprint_world();
        }
        // Lips are re-added after the cut so they still enter the touchpad.
        if (TOUCHPAD && (PART == "bottom" || PART == "all"))
            tp_lips_world();
    }
}

module left_half_placed() {
    half_placed();
}

module right_half_placed() {
    translate([RIGHT_OFFSET, 0, 0]) mirror([1,0,0])
        half_placed();
}

// Lift single printable parts so their lowest point sits on z=0.
// The top part is offset from the bottom plane by -ZBED, and the tilt lowers
// its lowest edge by that distance times (1 - cos(HALF_TILT)).
BED_LIFT =
    (PART == "bottom") ? -ZBED :
    (PART == "touchpad") ? -(ZBED + TP_LIFT) :
    (PART == "top") ? -ZBED*(1 - cos(HALF_TILT)) : 0;

module selected() {
    translate([0, 0, BED_LIFT]) {
        if (SIDE == "left" || SIDE == "both") left_half_placed();
        if (SIDE == "right" || SIDE == "both") right_half_placed();
        if (TOUCHPAD && (PART == "touchpad" || (PART == "all" && SIDE == "both")))
            touchpad_placed();
    }
}
selected();

// --- Or load the DXF files (same geometry) ---
// difference() {
//     linear_extrude(BOARD_THICKNESS) import("wodox_board_outline.dxf");
//     translate([0,0,-1]) linear_extrude(BOARD_THICKNESS+2) import("wodox_board_cutouts.dxf");
// }
