woczach/wodox/(list of files, cad)

Other CAD files:
outputs/outlines/wodox_board_profile.dxf
outputs/outlines/stl/wodox_bottom_right.stl
outputs/outlines/wodox_board_outline.dxf
outputs/outlines/stl/wodox_top_left.stl
outputs/outlines/wodox_board_cutouts.dxf
