woczach/wodox/outputs/pcbs/main_pcb.kicad_pcb

## KiCad design outputs/pcbs/main_pcb.kicad_pcb (2026-09-29)

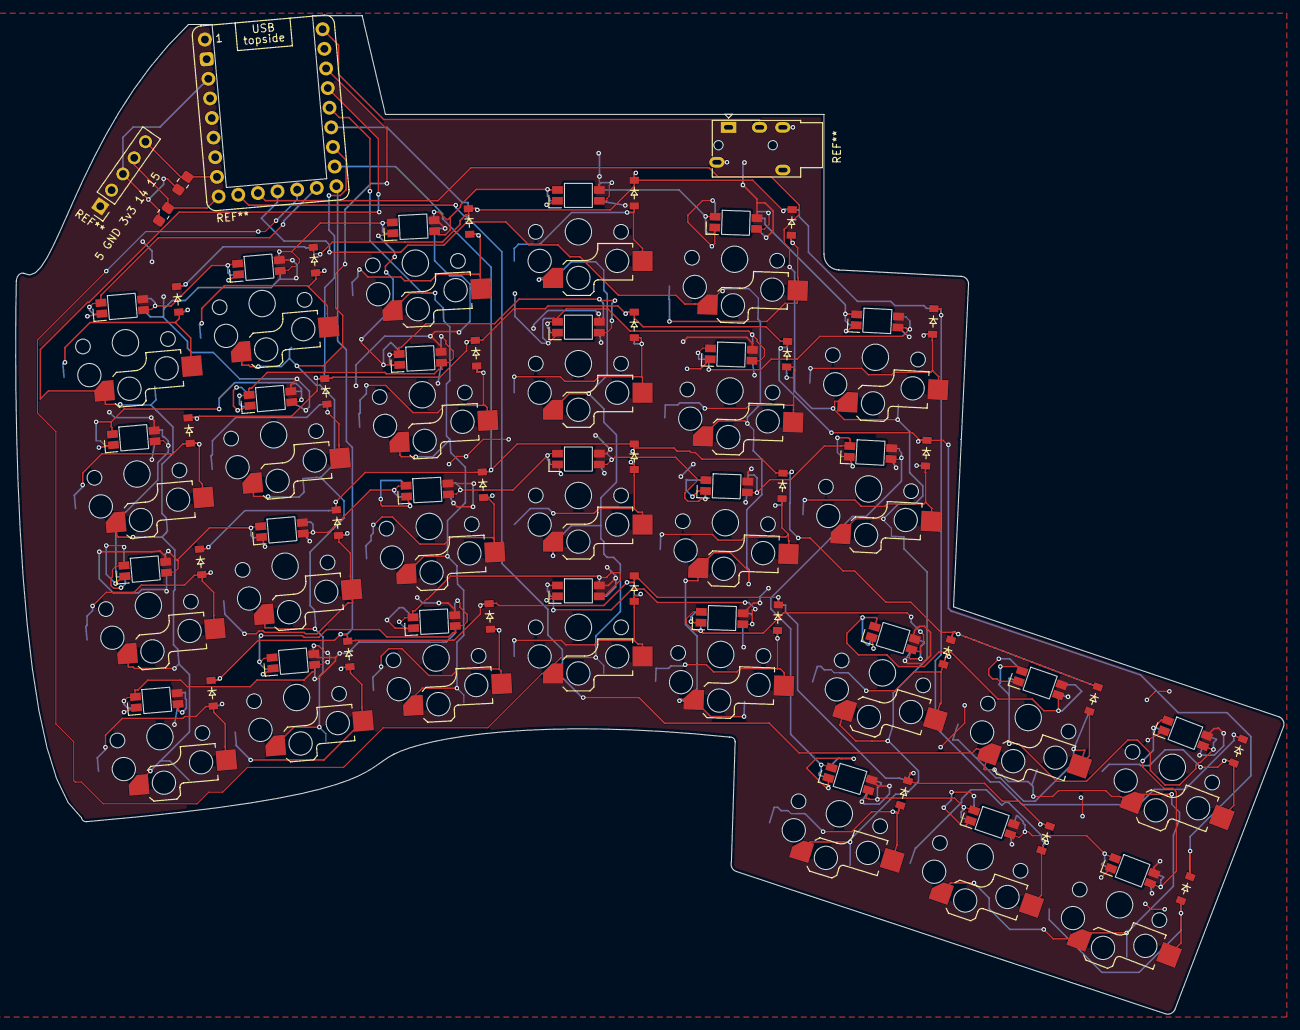
[picture p7: board main_pcb.kicad_pcb from above]

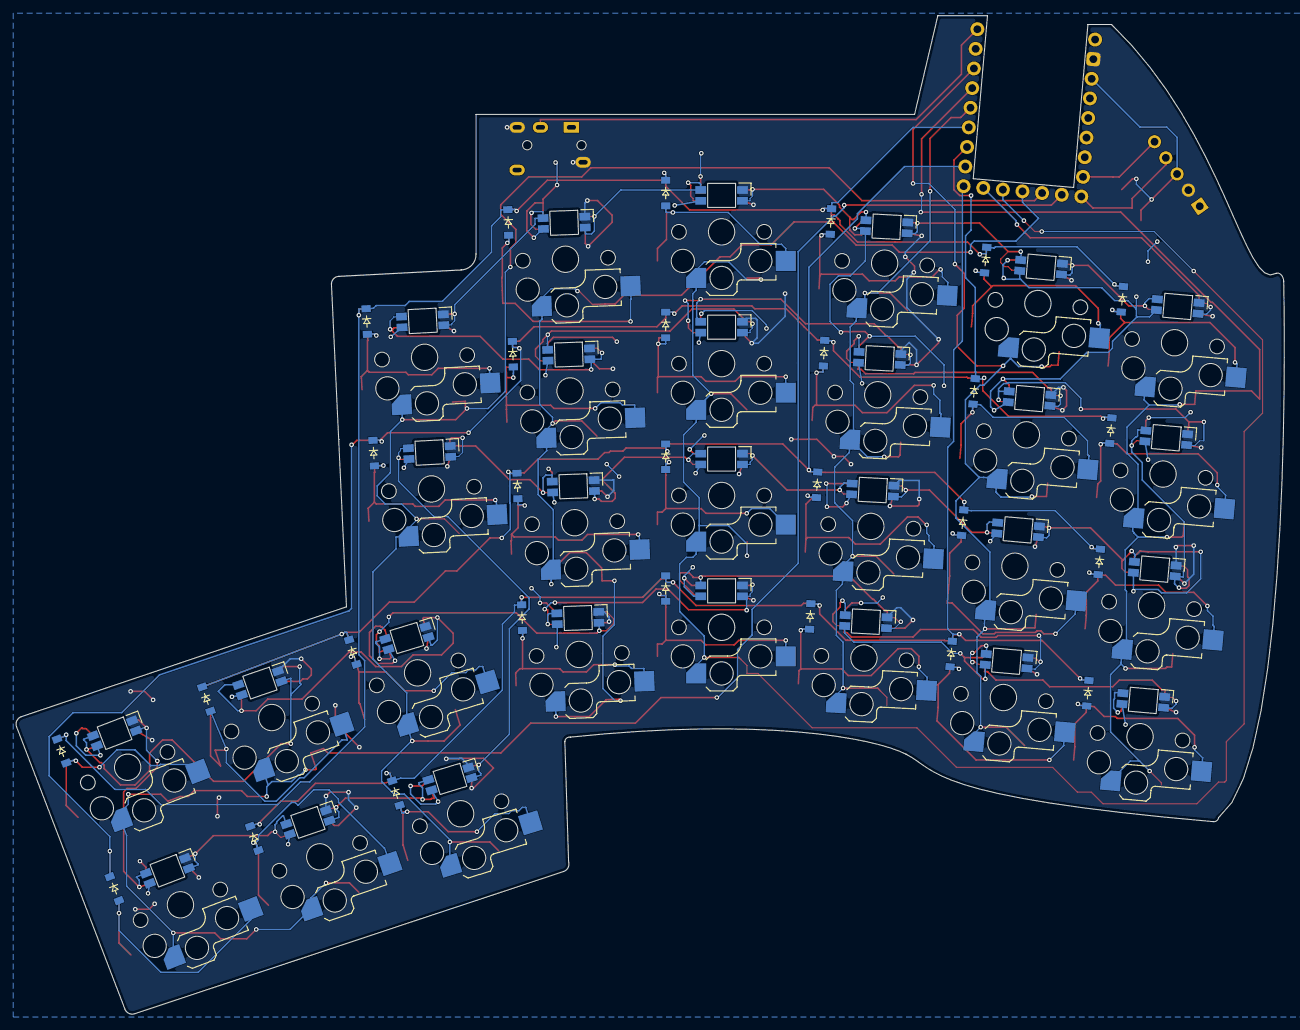
[picture p8: board main_pcb.kicad_pcb from below]

Board: 2 copper layers, 163.5 x 128.8 mm, 84 parts (28 on the bottom side), 68 nets.

Parts:
D1, D2, D3, D4, D5, D6, D7, D8, D9, D10, D11, D12, D13, D14, D15, D16, D17, D18, D19, D20, D21, D22, D23, D24, D25, D26, D27, D28: diode_tht_sod123
LED1, LED2, LED3, LED4, LED5, LED6, LED7, LED8, LED9, LED10, LED11, LED12, LED13, LED14, LED15, LED16, LED17, LED18, LED19, LED20, LED21, LED22, LED23, LED24, LED25, LED26, LED27, LED28: led_SK6812mini-e (per-key, reversible)
S1, S2, S3, S4, S5, S6, S7, S8, S9, S10, S11, S12, S13, S14, S15, S16, S17, S18, S19, S20, S21, S22, S23, S24, S25, S26, S27, S28: switch_choc_v1_v2

Connections:
D1: LED4.2, LED8.4
D2: LED8.2, LED12.4
D3: LED12.2, LED16.4
D4: LED16.2, LED20.4
D5: LED20.2, LED22.4
D6: LED19.4, LED22.2
D7: LED15.4, LED19.2
D8: LED11.4, LED15.2
D9: LED7.4, LED11.2
D10: LED3.4, LED7.2
D11: LED2.4, LED3.2
D12: LED2.2, LED6.4
D13: LED6.2, LED10.4
D14: LED10.2, LED14.4
D15: LED14.2, LED18.4
D16: LED18.2, LED21.4
D17: LED21.2, LED23.4
D18: LED23.2, LED25.4
D19: LED25.2, LED27.4
D20: LED27.2, LED28.4
D21: LED26.4, LED28.2
D22: LED24.4, LED26.2
D23: LED17.4, LED24.2
D24: LED13.4, LED17.2
D25: LED9.4, LED13.2
D26: LED5.4, LED9.2
D27: LED1.4, LED5.2
GND: LED1.3, LED2.3, LED3.3, LED4.3, LED5.3, LED6.3, LED7.3, LED8.3, LED9.3, LED10.3, LED11.3, LED12.3, LED13.3, LED14.3, LED15.3, LED16.3, LED17.3, LED18.3, LED19.3, LED20.3, LED21.3, LED22.3, LED23.3, LED24.3, LED25.3, LED26.3, LED27.3, LED28.3
K_0: S1.1, S2.1, S3.1, S4.1
K_1: S5.1, S6.1, S7.1, S8.1
K_2: S9.1, S10.1, S11.1, S12.1
K_3: S13.1, S14.1, S15.1, S16.1
K_4: S17.1, S18.1, S19.1, S20.1
K_5: S21.1, S22.1, S23.1, S24.1
R_0: D4.1, D8.1, D12.1, D16.1, D20.1, D22.1, D28.1
R_1: D3.1, D7.1, D11.1, D15.1, D19.1, D21.1, D27.1
R_2: D2.1, D6.1, D10.1, D14.1, D18.1, D24.1, D26.1
R_3: D1.1, D5.1, D9.1, D13.1, D17.1, D23.1, D25.1
VCC: LED1.1, LED2.1, LED3.1, LED4.1, LED5.1, LED6.1, LED7.1, LED8.1, LED9.1, LED10.1, LED11.1, LED12.1, LED13.1, LED14.1, LED15.1, LED16.1, LED17.1, LED18.1, LED19.1, LED20.1, LED21.1, LED22.1, LED23.1, LED24.1, LED25.1, LED26.1, LED27.1, LED28.1
k_0_r_0: D4.2, S4.2
k_0_r_1: D3.2, S3.2
k_0_r_2: D2.2, S2.2
k_0_r_3: D1.2, S1.2
k_1_r_0: D8.2, S8.2
k_1_r_1: D7.2, S7.2
k_1_r_2: D6.2, S6.2
k_1_r_3: D5.2, S5.2
k_2_r_0: D12.2, S12.2
k_2_r_1: D11.2, S11.2
k_2_r_2: D10.2, S10.2
k_2_r_3: D9.2, S9.2
k_3_r_0: D16.2, S16.2
k_3_r_1: D15.2, S15.2
k_3_r_2: D14.2, S14.2
k_3_r_3: D13.2, S13.2
k_4_r_0: D20.2, S20.2
k_4_r_1: D19.2, S19.2
k_4_r_2: D18.2, S18.2
k_4_r_3: D17.2, S17.2
k_5_r_1: D22.2, S22.2
k_5_r_2: D21.2, S21.2
t1_td: D23.2, S23.2
t1_tu: D24.2, S24.2
t2_td: D25.2, S25.2
t2_tu: D26.2, S26.2
t3_td: D27.2, S27.2
t3_tu: D28.2, S28.2
t_2: S25.1, S26.1, S27.1, S28.1
