woczach/wodox/(commit log)

2026-09-27 cpu added
    [main_pcb.kicad_pcb]
2026-09-27 all good1
    [main_pcb.kicad_pcb]
2026-09-28 different nets
    [main_pcb.kicad_pcb]
2026-09-29 all connected all good
    [main_pcb.kicad_pcb]
2026-10-02 cutout with lip
    [wodox_board.scad]
2026-10-02 added jack
    [wodox_board.scad]
2026-10-02 top and bottom
    [wodox_board.scad]
2026-10-02 top and bottom with outline
    [wodox_board.scad]
2026-10-02 jack and usb cutouts
    [wodox_board.scad]
2026-10-16 NAV layer: left-hand RGB sweep, remove brackets/PGUP/PrtSc
2026-10-20 keymap-drawer: draw bracket combos, add build script
2026-10-20 Combos for PrtSc/grave/tilde, shift bracket combos one key right, plain MO for DEV/TMUX
